StuartKenny/PRS10_rack/README.md

# PRS10
PSU and USB connectivity for PRS10 enclosure
