StuartKenny/PRS10_rack/Panel/PanelNotes.docx

# PRS10 Front Panel

# Software output format

dxf format required for laser cutter

Autodesk. From the dwg view – File > Save As > Save Copy As > DXF File. Need to make sure that letters are raised or lowered as an extrusion so that they register correctly.

Corel Draw is easy and recommended

# Dimensions

Panel - 88x399mm

LEDs - 5mm dia (on 15mm centres)

screws - 3mm dia

USB - 10.7mm tall x 12mm wide

switch - 20.2mm dia plus manual 2.2x0.9mm notch

RF connectors - 6.55mm dia flattened to 6.12

# Logo

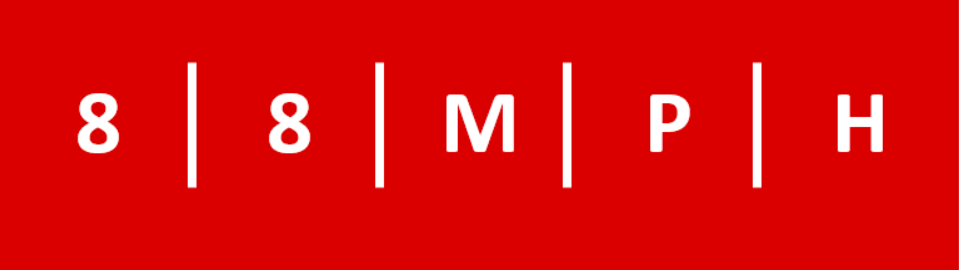
[picture p7: figure]
