StuartKenny/PRS10_rack/PRS10_BoM.xlsx

Sheet: PRS10
Designator | P/N | Description |  | Qty | Link
Xformer | MCTA080/12 | 2x12V 80VA toroid |  | 1 | http://uk.farnell.com/multicomp/mcta080-12/transformer-toroidal-2-x-12v-80va/dp/9532706
 | RIS0422H2 | Fused, filtered, switched mains inlet |  | 1 | http://uk.farnell.com/roxburgh/ris0422h2/filter-inlet-iec-4a-twin-fused/dp/1428692
 | 0213001.MXP | Fuse - 1A anti-surge |  | 1 | https://uk.rs-online.com/web/p/cartridge-fuses/5412931/
 | R13244AAAA | DPST switch |  | 1 | http://uk.farnell.com/arcolectric/r13244aaaa/switch-dpst-10a-250vac-black-i/dp/7674090
 | 0-0031894-0 | M6 crimp ring |  | 2 | http://uk.farnell.com/amp-te-connectivity/0-0031894-0/terminal-ring-tongue-6mm-crimp/dp/4217391?st=m6%20crimp
 | 34162 | M6 crimp ring |  |  | http://uk.farnell.com/amp-te-connectivity/34162/terminal-ring-tongue/dp/1557046
 | 165035 | M6 crimp ring |  |  | http://uk.farnell.com/amp-te-connectivity/165035/terminal-ring-tongue-1-4-10awg/dp/2506323
 | 2-520184-4 | Faston crimp terminals |  | 3 | http://uk.farnell.com/amp-te-connectivity/2-520184-4/terminal-female-disconnect-22/dp/2293338
 |  | Earth cable
 | 14825295 | Case |  | 1 | https://uk.rs-online.com/web/p/rack-fitting-cases-enclosures/8104359/
 | 345AB1000B | TO-66 Heatsink |  | 1 | http://uk.farnell.com/abl-heatsinks/345ab1000b/heat-sink-1-c-w/dp/150016
 | 520AB0750MB(T03) | TO-3 heatsink |  | 1 | http://uk.farnell.com/abl-heatsinks/520ab0750mb-t03/heat-sink-to-3-1-65-c-w/dp/253716
 | 534-4726 | TO-66-2 mounting kit | Mouser | 2 | https://www.mouser.co.uk/ProductDetail/Keystone-Electronics/4726
 | MK3301/51 | TO-3 insulator |  | 1 | http://uk.farnell.com/multicomp/mk3301-51/insulating-kit-mica-to-3/dp/520184?st=to-3%20mounting%20kit
 | MK3304 | Screws for TO-3 & TO-66 |  | 1 | https://uk.rs-online.com/web/p/heatsink-mounting-accessories/0298493/?searchTerm=to-66+mounting
 | R1811B91 | PCB stand-offs |  |  | https://uk.rs-online.com/web/p/hex-spacers/1057754/
 | 142-0701-401 | SMA sockets |  | 3 | https://uk.rs-online.com/web/p/sma-connectors/8861074/
 | PD.2115BL | Feet |  | 4 | http://uk.farnell.com/multicomp/pd-2115bl/feet-stick-on-5x11-1dia-blk-pk55/dp/1800839
 | 81.58.336 | PRS10 screws - #4-40 UNC-2B 0.25" deep | Fastpack | 4 | http://uk.farnell.com/ettinger/81-58-336/screw-pan-head-pozi-steel-m3-8mm/dp/2494539?st=m3%20screw
 | MRPM030040CB | Black M3 40mm screws |  | 7 | http://uk.farnell.com/unbranded/mrpm030040cb/screw-pan-head-pz-m3-x-40mm-pk50/dp/2528959?st=m3+screw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
 | M3- HFST-Z100- | M3 nuts |  | 7 | http://uk.farnell.com/duratool/m3-hfst-z100/nut-full-steel-bzp-m3-pk100/dp/1419447
 | DM3-FASTWAZ100DIN125 | M3 washers |  | 7 | http://uk.farnell.com/duratool/dm3-fastwaz100din125/plain-washer-steel-3mm-7mm/dp/2506007
 | N80.375 PRSTABB100- | No.8 self tapping screws |  | 8 | http://uk.farnell.com/tr-fastenings/n80-375-prstabb100/screw-pozi-pan-steel-blk-8x3-8/dp/1420523
J7 | 61400416121 | Right angle USB PCB connector |  | 1 | https://uk.rs-online.com/web/p/type-b-usb-connectors/7480866/
J2 | FME008P102 | 50 Ohm, co-axial R/A plug |  | 1 | https://www.mouser.co.uk/productdetail/fct-electronics/fme008p102
J2 | FM11W1S5-K121 | 11W1 socket, PCB 90degrees | Mouser | 1 | https://www.mouser.co.uk/ProductDetail/FCT-Electronics/173107-0319
J6 | M22-7131042 | 10 way receptacle |  | 1
J3 | M22-2031005 | 10 way right-angle header |  | 1
J5 | M22-7130842 | 8 way receptacle |  | 1
J4 | M22-2030805 | 8 way right-angle header |  | 1
J1, J8 | 790-1082 | 8-way terminal block |  | 2 | https://uk.rs-online.com/web/p/pcb-terminal-blocks/7901082/
 | 790-1076 | 4-way terminal block |  | 1 | https://uk.rs-online.com/web/p/pcb-terminal-blocks/7901076/
L1 | MMZ2012S601A | Ferrite, 600R @ 100MHz, 500mA, 0805 package |  | 1 | https://www.mouser.co.uk/ProductDetail/?qs=g8DL0B6GkTnXrzduh8Z92A%3D%3D
Q1 | 2N3054 | NPN power transistor | Mouser | 2 | https://www.mouser.co.uk/ProductDetail/Central-Semiconductor/2N3054/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
 | BSS64 | NPN transistor SOT23 |  | 1
 | FT231XS | RS232 to USB chip, SSOP-20 |  | 1 | https://www.sci-ware-customer.com/sword/catalogueItem.do?context=search&key=15069497
 | LM723CN | IC REG LIN POS ADJ 150MA 14DIP |  | 2 | https://www.sci-ware-customer.com/sword/catalogueItem.do?context=search&key=18970898
 | LM833 | Dual op-amp
 | 2N4401 | NPN BJT
 | LM338K | TO-3 voltage regulator |  | 1
 | 1N4002 | 1A 100V silicon rectifier |  | 2
BR1 | KBU4G | Bridge rectifier 400V 4A |  | 1 | https://uk.rs-online.com/web/p/products/6296667/
 | L7113SGD-LC27SF1.5 | 5mm green LED |  | 6 | https://uk.rs-online.com/web/p/visible-leds/6466658/
C1 | MC1206N101J500CT | 100pF 1206 capacitor |  | 4 | http://uk.farnell.com/multicomp/mc1206n101j500ct/cap-mlcc-c0g-np0-100pf-50v-1206/dp/1759327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
 | MC1206B103K500CT | 10nF 1206 capacitor |  | 1 | http://uk.farnell.com/multicomp/mc1206b103k500ct/cap-mlcc-x7r-10nf-50v-1206/dp/1759350
 | MC1206B104K500CT | 100nF 1206 capacitor |  | 5 | http://uk.farnell.com/multicomp/mc1206b104k500ct/cap-mlcc-x7r-100nf-50v-1206/dp/1759361
 | MC1206B105K500CT | 1uF capacitor |  | 1 | http://uk.farnell.com/multicomp/mc1206b105k500ct/cap-mlcc-x7r-1uf-50v-1206/dp/1759454
 | MC1206B475K500CT | 4.7uF capacitor |  | 3 | http://uk.farnell.com/multicomp/mc1206b475k500ct/cap-mlcc-x7r-4-7uf-50v-1206/dp/2320908
 | MCRH50V226M5X11 | 22uF |  | 2 | http://uk.farnell.com/multicomp/mcrh50v226m5x11/cap-alu-elec-22uf-50v-rad/dp/1902929
 | ECA-2AM101 | 100u cap |  | 1 | https://www.digikey.com/product-detail/en/panasonic-electronic-components/ECA-2AM101/P5313-ND/245067
 | MCKLZ100M472P40Y | 4700u, 100V electrolytic |  | 2 | http://uk.farnell.com/multicomp/mcklz100m472p40y/cap-alu-elec-4700uf-100v-snap/dp/2610775
 | 3269W-1-102LF | 1k trimmer, 250mW, 10% |  | 2 | http://uk.farnell.com/bourns/3269w-1-102lf/trimmer-smd-12-turn-1k/dp/9352953?st=3269W-1-102LF
RV2 | 3269W-1-501LF | 500R trimmer, 250mW, 10% |  | 1 | http://uk.farnell.com/bourns/3269w-1-501lf/trimmer-12-turn-500r-0-25w/dp/1612581?pf=110167406%2C112882636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
 | ERJ8CWFR050V | 0.05R 1W 1206 1% |  | 2 | http://uk.farnell.com/panasonic-electronic-components/erj8cwfr050v/resistor-thick-film-1206-0-05r/dp/2253991
 | CRG1206F15R | 15R |  | 2
 | CRCW120627R0FKEA | 27R 1206 resistor |  | 2
 | CRG1206F120R | 120R 1206 resistor |  | 1
 | CRG1206F220R | 220R |  | 2
 | CRG1206F270R | 270R 1206 resistor |  | 2 | https://uk.rs-online.com/web/p/surface-mount-fixed-resistors/2232136/
 | CRG1206F470R | 470R |  | 2
 | CRG1206F1K0 | 1k 1206 resistor |  | 3
 | CRG1206F1K2 | 1.2k 1206 resistor |  | 3
 | CRG1206F1K5 | 1.5k 1206 resistor |  | 2
 | CRG1206F2K0 | 2k 1206 resistor |  | 1 | https://uk.rs-online.com/web/p/surface-mount-fixed-resistors/2232300/
 | WCR1206-4K3FI | 4k3 |  | 2
R2 | CRG1206F6K8 | 6.8k 1206 resistor |  | 2
 | CRG1206F8K2 | 8.2k 1206 resistor |  | 1
R3 | ERA8AEB912V | 9.1k 1206 resistor |  | 2
 | CRG1206F10K | 10k 1206 resistor |  | 3
 | CRG1206F22K | 22k 1206 resistor |  | 2 | RHM22.0KAITR-ND (https://www.digikey.co.uk/product-detail/en/rohm-semiconductor/KTR18EZPF2202/RHM22.0KAITR-ND/1983713)
 | CRG1206F47k | 47k |  | 2
 | WCR1206-300KFI | 300k |  | 2

Sheet: Awaiting
Order | Supplier | P/N | Description
419001 | RS | 1251190P | CRG1206 SMT Chip Resistor 1K 0.25W
419002 | Onecall | 2320908 | CAP, MLCC, X7R, 4.7UF, 50V, 1206
419116 | Onecall |  | 100uF caps
 |  | ERJ8ENF2001V | 2k resistors?

Sheet: Misc_kit
Designator | P/N | Description | Qty | Link
 | 430019 | Crimp tool | 1 | http://uk.farnell.com/ck-tools/430019/ratchet-crimping-pliers/dp/1879381?MER=sy-me-pd-mi-alte
 | D00391 | Torq bits |  | http://uk.farnell.com/duratool/d00391/bit-set-security-33pc/dp/1341140?st=torq
 | 5011-A3C | Ratchet screwdriver | 1 | http://uk.farnell.com/duratool/5011-a3c/screwdriver-ratchet-6-bits/dp/3126821?st=ratchet%20screwdriver
 | 553-0500-01 | Red 4mm plugs | 5 | http://uk.farnell.com/deltron-components/553-0500-01/plug-4mm-stackable-red-16a/dp/1101099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
 | 553-0100-01 | Black 4mm plugs | 5 | http://uk.farnell.com/deltron-components/553-0100-01/plug-4mm-stackable-black-16a/dp/1101106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
 | 553-0200-01 | Blue 4mm plugs | 5 | http://uk.farnell.com/deltron-components/553-0200-01/plug-10a-4mm-stackable-cable-blue/dp/1101108
 | 553-0400-01 | Green 4mm plugs | 5 | http://uk.farnell.com/deltron-components/553-0400-01/plug-10a-4mm-stackable-cable-green/dp/1101107
 | 553-0700-01 | Yellow 4mm plugs | 5 | http://uk.farnell.com/deltron-components/553-0700-01/banana-plug-10a-4mm-stackable/dp/1101111
 | HS510-1.22M | Heatshrink 1.5mm |  | http://uk.farnell.com/pro-power/sp3x15-1-2-black/heatshrink-1-5mm-black-1-2m/dp/1191009
 | HS511-1.22M | Heatshrink 3mm |  | http://uk.farnell.com/pro-power/hs511-1-22m/heatshrink-3mm-black-1-22m/dp/1259195
 | HS512-1.22M | Heatshrink 4.5mm |  | http://uk.farnell.com/pro-power/hs512-1-22m/heatshrink-4-5mm-black-1-2m/dp/1259196
 | HS513-1.22M | Heatshrink 6mm |  | http://uk.farnell.com/pro-power/sp3x6-2-1-2mblack/heatshrink-6mm-black-1-2m/dp/1191012
 | HS514-1.22M | Heatshrink 9mm |  | http://uk.farnell.com/pro-power/hs514-1-22m/heatshrink-3-1-9mm-black-1-22m/dp/1259198

Sheet: Considered
Designator | P/N | Description | Link
PSU | LS75-24 | 24V 3.2A PSU | http://uk.farnell.com/tdk-lambda/ls75-24/psu-enclosed-24v-3-2a-75w/dp/1657447?mckv=YO18ZYDl_dc|pcrid|78108376509|&gross_price=true&CATCI=aud-157604796549:pla-41477300408&CAAGID=14406255429&CMP=KNC-GUK-GEN-SHOPPING&CAGPSPN=pla&gclid=CjwKCAiAtdDTBRArEiwAPT4y-4A-DQu4D2N3cmYq1lzJCUIhXC5sN3gK5JRb-vx67Er8iVF--yA4AxoCEMAQAvD_BwE&CAWELAID=120173390000288793
 | 28L0138-10R-10 | Ferrite, Axial Leaded, 75 ohm, 5 A, 0.01 ohm | http://uk.farnell.com/laird-technologies/28l0138-10r-10/filter-3-5x4-5-59mm-100mhz-75r/dp/2292304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
 | PM5.08/2/90 BLK | 2-way terminal block | http://uk.farnell.com/weidmuller/pm5-08-2-90-blk/terminal-block-wire-to-brd-2pos/dp/1131855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
 | RIR-0422-H | Fused, filtered mains inlet | http://uk.farnell.com/roxburgh/rir-0422-h/filter-4a-fused/dp/1101083
 | AU-Y1007-R | Right angle USB PCB connector | Obsolete
 | FME008P102 | 50 Ohm, co-axial R/A plug | Not stocked | http://uk.farnell.com/fct-a-molex-company/fme008p102/koaxial-connector/dp/2433193
R1 | 9C12063A2202FKHFT | 22k 1206 resistor |  | https://www.digikey.co.uk/product-detail/en/yageo/9C12063A2202FKHFT/311-22.0KFTR-ND/346657
 | MC1206N470J500CT | 47pF 1206 capacitor |  |  | http://uk.farnell.com/multicomp/mc1206n470j500ct/cap-mlcc-c0g-np0-47pf-50v-1206/dp/2320898
C1 | ecu-v1h101jch | 100pF 1206 capacitor |  | 4 | http://uk.farnell.com/multicomp/mc1206n101j500ct/cap-mlcc-c0g-np0-100pf-50v-1206/dp/1759327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
J6 | 25631001RP2 | 10 way receptacle | x | 1 | https://www.mouser.co.uk/productdetail/norcomp/25631001rp2
J3 | 27631002RP2 | 10 way right-angle header | x | 1 | https://www.mouser.co.uk/ProductDetail/NorComp/27631002RP2
J5 | 25630801RP2 | 8 way receptacle | x | 1
J4 | 27630802RP2 | 8 way right-angle header | x | 1
J7 | AU-Y1007 | Right angle USB PCB connector | Digikey | 1 | https://www.digikey.co.uk/product-detail/en/assmann-wsw-components/AU-Y1007/AE11183-ND/278928
 | ECF440 | PRS10 screws - M3x7mm (#4-40 UNC-2B 0.25" deep) | US stock |  | http://uk.farnell.com/l-com/ecf440/thread-size-metric/dp/2500400
 |  | Earth sleeve
 |  | Blue equipment wire | http://uk.farnell.com/pro-power/mc6a-1-0-6t2-be-100/equipment-wire-1-0-6mm-blue-100m/dp/1219343
RV1 | 3269P-1-102LF | 1k trimmer, 250mW, 10% |  | 1
 | PP000227 | Earth cable |  | 1 | http://uk.farnell.com/pro-power/pp000227/hook-up-wire-20awg-grn-yel-per/dp/2707912
 | 790-1070 | 5-way terminal block |  | 1 | https://uk.rs-online.com/web/p/pcb-terminal-blocks/7901070/

Sheet: RS232
Designator | P/N | Description | Qty | Link
 | CRG1206F10K | 10k 1206 resistor | 3
 | 74LS04 | Hex inverter DIP package | 1 | https://www.sci-ware-customer.com/sword/catalogueItem.do?context=search&key=43722539
 | L77SDE09SA4CH4R | 9-pin Dsub receptacle | 1 | http://uk.farnell.com/amphenol-commercial-products/l77sde09sa4ch4r/d-sub-conn-r-a-rcpt-9pos-solder/dp/2709065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

Sheet: PRSBB
Designator | P/N | Description |  | Qty | Link
 | SMA-CONNECTOR | PCB mounting SMA connector |  | 3 | https://uk.rs-online.com/web/p/sma-connectors/7839638/
L1 | MMZ2012S601A | Ferrite, 600R @ 100MHz, 500mA, 0805 package |  | 1 | https://www.mouser.co.uk/ProductDetail/?qs=g8DL0B6GkTnXrzduh8Z92A%3D%3D
 | BSS64 | NPN transistor SOT23 |  | 1
 | FT231XS | RS232 to USB chip, SSOP-20 |  | 1 | https://www.sci-ware-customer.com/sword/catalogueItem.do?context=search&key=15069497
 | L7113SGD-LC27SF1.5 | 5mm green LED |  | 4 | https://uk.rs-online.com/web/p/visible-leds/6466658/
J7 | 61400416121 | Right angle USB PCB connector |  | 1 | https://uk.rs-online.com/web/p/type-b-usb-connectors/7480866/
J2 | FME008P102 | 50 Ohm, co-axial R/A plug | RS | 1 | https://www.mouser.co.uk/productdetail/fct-electronics/fme008p102
J2 | FM11W1S5-K121 | 11W1 socket, PCB 90degrees | Mouser | 1 | https://www.mouser.co.uk/ProductDetail/FCT-Electronics/173107-0319
C1 | MC1206N101J500CT | 100pF 1206 capacitor |  | 2 | http://uk.farnell.com/multicomp/mc1206n101j500ct/cap-mlcc-c0g-np0-100pf-50v-1206/dp/1759327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
 | MC1206B103K500CT | 10nF 1206 capacitor |  | 1 | http://uk.farnell.com/multicomp/mc1206b103k500ct/cap-mlcc-x7r-10nf-50v-1206/dp/1759350
 | MC1206B104K500CT | 100nF 1206 capacitor |  | 4 | http://uk.farnell.com/multicomp/mc1206b104k500ct/cap-mlcc-x7r-100nf-50v-1206/dp/1759361
 | UMK316BJ475KL-T | 4.7uF capacitor |  | 1 | http://uk.farnell.com/multicomp/mc1206b475k500ct/cap-mlcc-x7r-4-7uf-50v-1206/dp/2320908
 | CRCW120627R0FKEA | 27R 1206 resistor |  | 2
 | CRG1206F270R | 270R 1206 resistor |  | 2 | https://uk.rs-online.com/web/p/surface-mount-fixed-resistors/2232136/
 | MCWR12X1001FTL | 1k 1206 resistor |  | 2
 | CRG1206F1K2 | 1.2k 1206 resistor |  | 2
 | CRG1206F8K2 | 8.2k 1206 resistor |  | 1
 | CRG1206F10K | 10k 1206 resistor |  | 3
