StuartKenny/PRS10_rack/Datasheets/RM2U0808VBK.stp

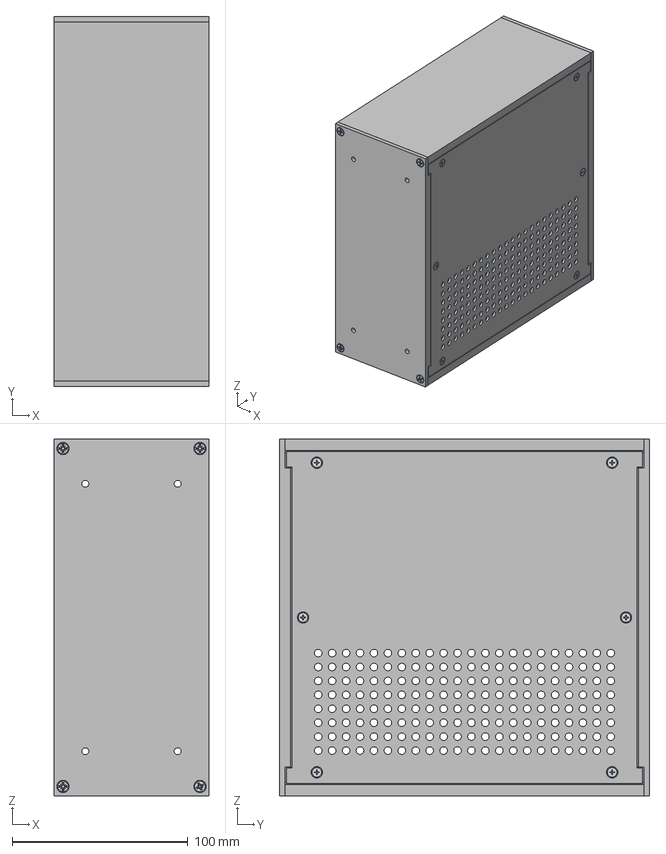
[picture p8: CAD file, 2018-02-23]
Datasheets/RM2U0808VBK.stp
88.1 x 210.8 x 203.2 mm
2U Side 8in x 2
2U Front x 2
AS B194 CR1 B No. 4 x 3/8-CR1 B x 13
Cross Recessed Flat Countersunk Head Tapping Screw - Type C - Type IA - Inch 6-32 UNC - 0.625 x 8
tinnerman Nut - 4-40 x 12
Vented Top Panel x 2
