StuartKenny/PRS10_rack/Panel/Panelv03.dxf

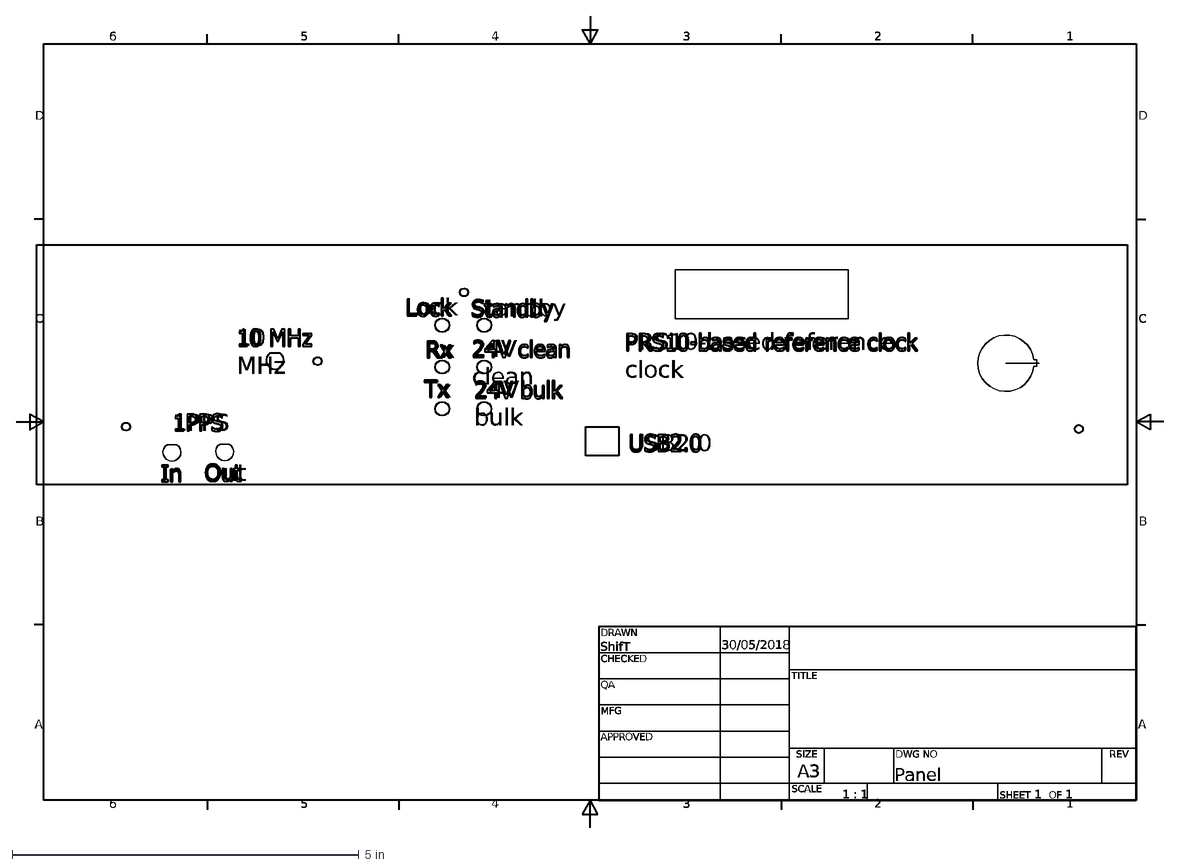
[picture p9: CAD file, 2018-06-04]
Panel/Panelv03.dxf
1
2
3
4
5
6
A
B
C
D
ShifT
30/05/2018
Panel
A3
1 : 1
SHEET 1 OF 1
DRAWN
CHECKED
QA
MFG
APPROVED
DWG NO
TITLE
SIZE
SCALE
REV
Rx
Tx
24V bulk
24V clean
Standby
USB2.0
1PPS
Out
Lock
10 MHz
PRS10-based reference clock
In
