StuartKenny/PRS10_rack/(list of files, cad)

Other CAD files:
Panel/Panel.dwg
Panel/try1.dwg
Panel/OldVersions/Panel.0004.dwg
3D/Enclosure.ipt
3D/OldVersions/Enclosure.0001.ipt
Panel/OldVersions/Panel.0014.ipt
Panel/Panel.ipt
