StuartKenny/PRS10_rack/Mobo_schematics_v0.4.pdf

# AC to DC conversion

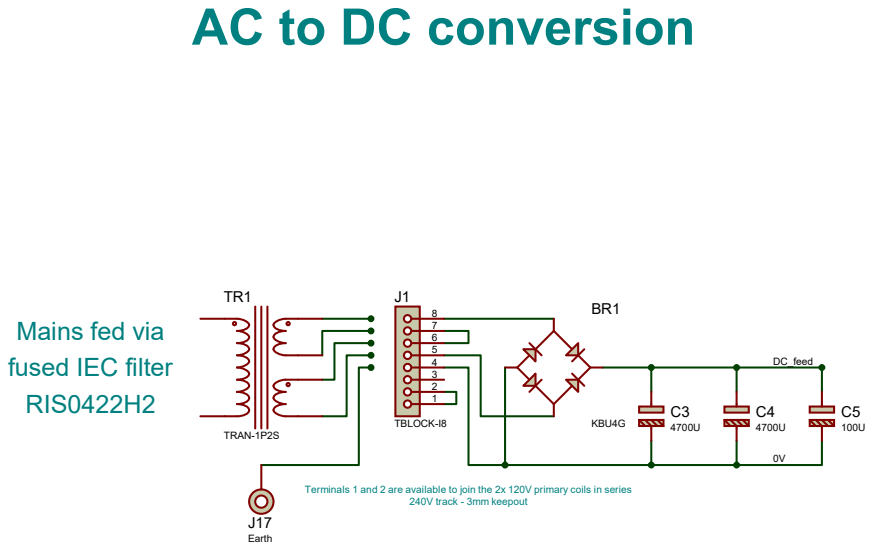
[picture p10: page 1]
DC_feed; TRAN-1P2S; KBU4G; TBLOCK-I8; Earth; 240V track - 3mm keepout

Mains fed via
fused IEC filter
RIS0422H2

Terminals 1 and 2 are available to join the 2x 120V primary coils in series

R3

# Voltage regulators

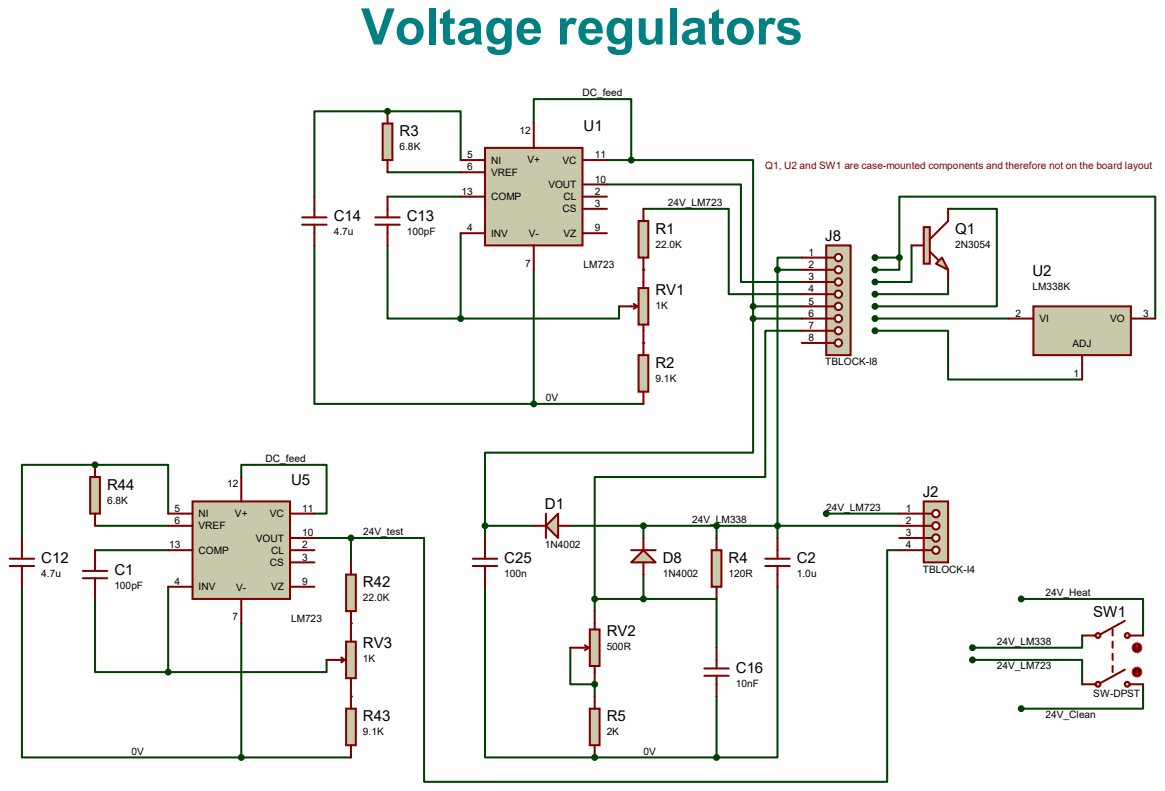
[picture p11: page 2]

Q1, U2 and SW1 are case-mounted components and therefore not on the board layout

# Wenzel shunts

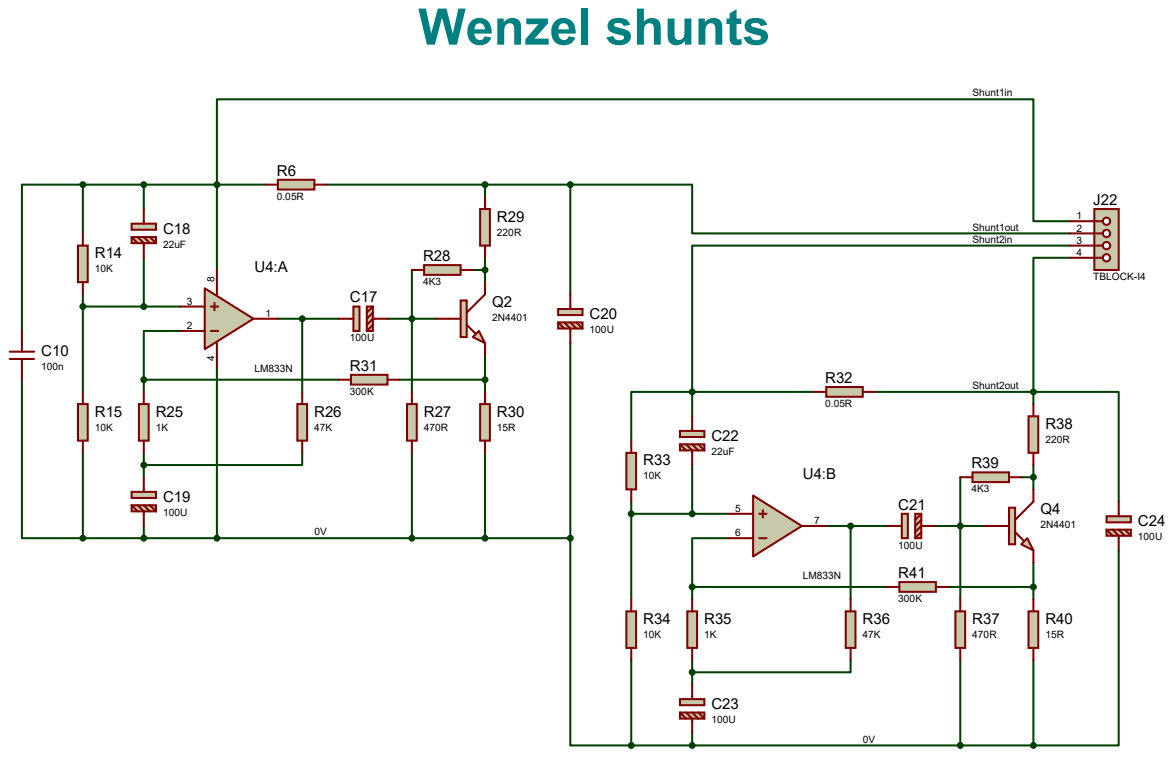
[picture p12: page 3]

# RS232 to USB conversion

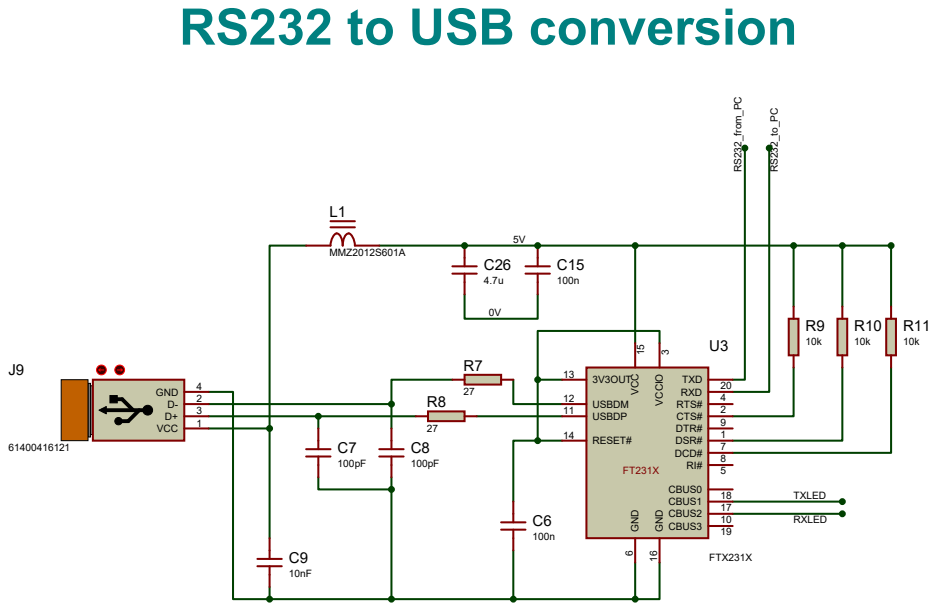
[picture p13: page 4]

# Daughterboard connectors

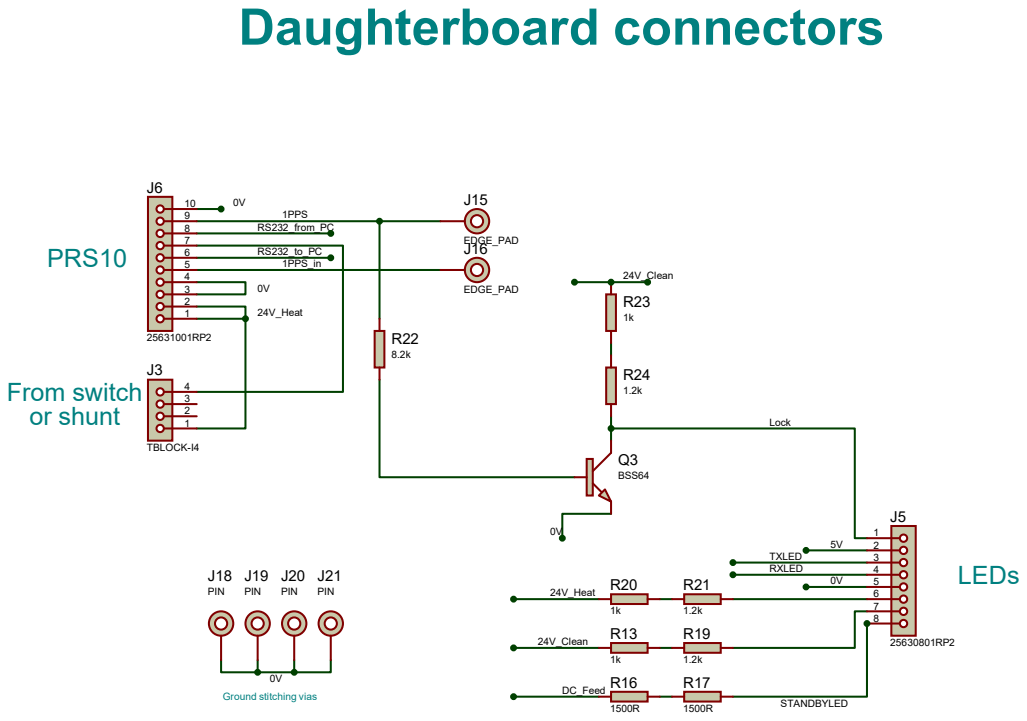
[picture p14: page 5]
