StuartKenny/PRS10_rack/Schematics_v0.3.pdf

# AC to DC conversion

DC_feed; TRAN-1P2S; KBU4G; TBLOCK-I8; Earth; 240V track - 3mm keepout

Mains fed via
fused IEC filter
RIS0422H2

Terminals 1 and 2 are available to join the 2x 120V primary coils in series

R3

# Voltage regulators

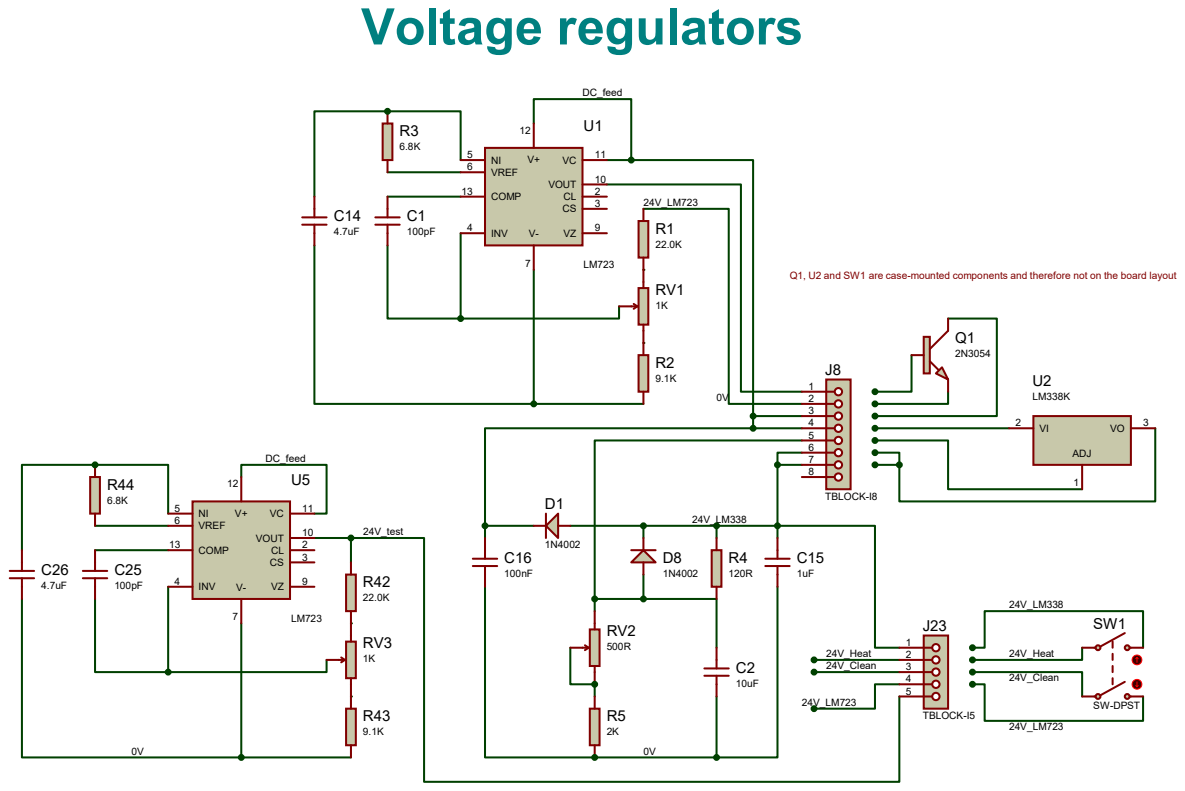
[picture p15: page 2]

Q1, U2 and SW1 are case-mounted components and therefore not on the board layout

# Wenzel shunts

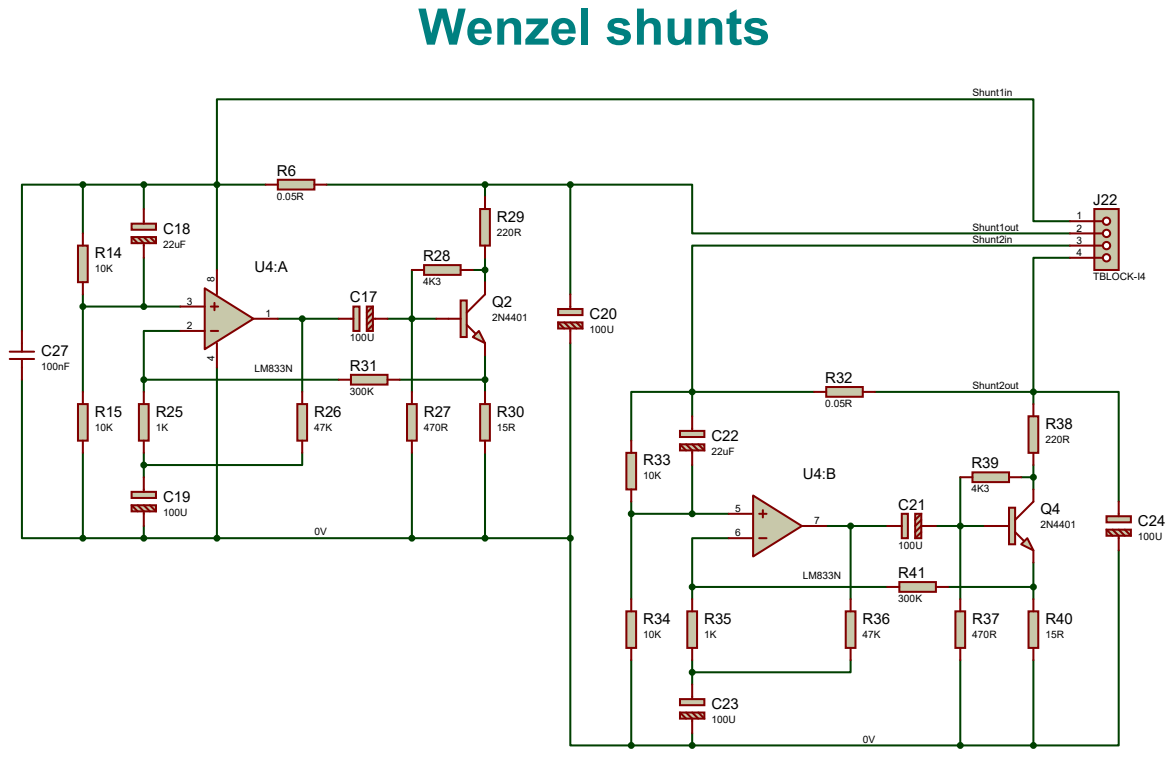
[picture p16: page 3]

# RS232 to USB conversion

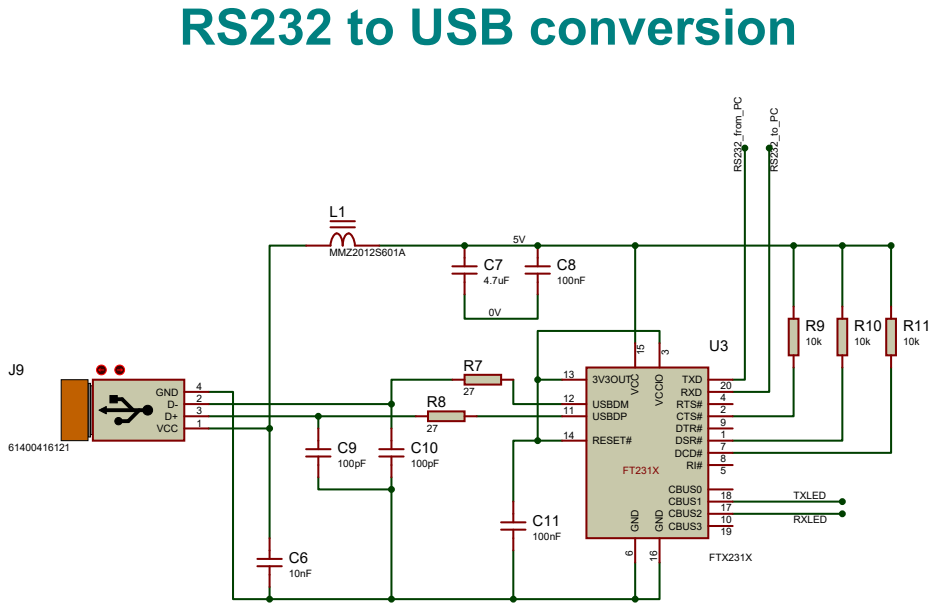
[picture p17: page 4]

# Daughterboard connectors

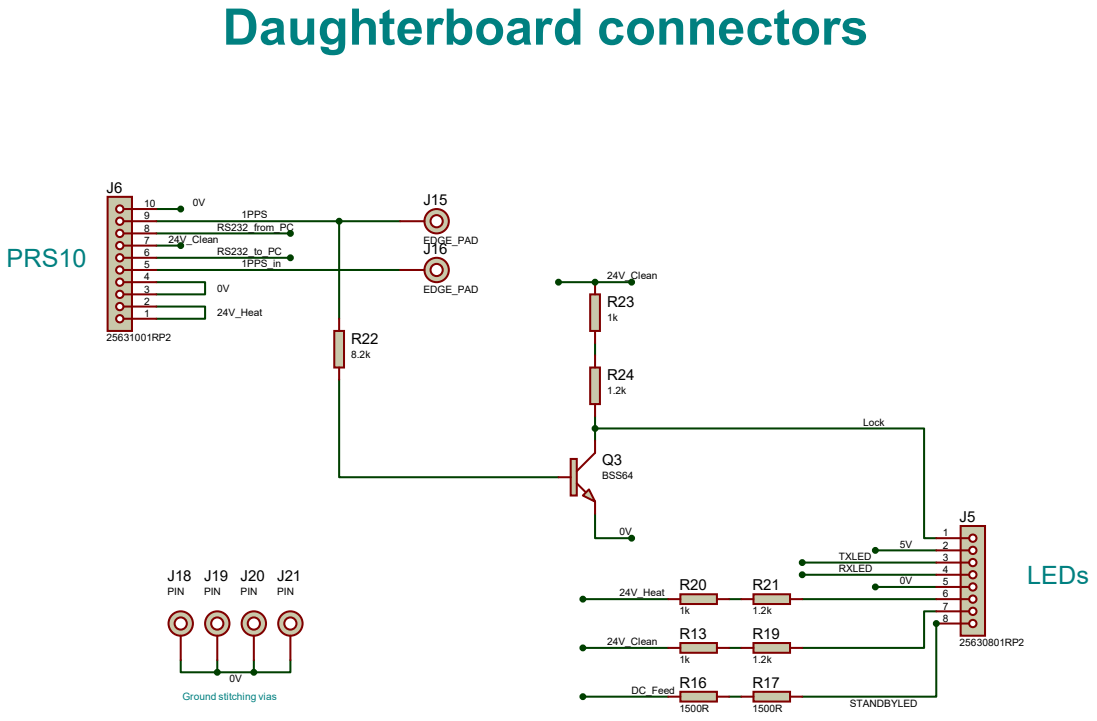
[picture p18: page 5]

# PRS10 connector daughterboard

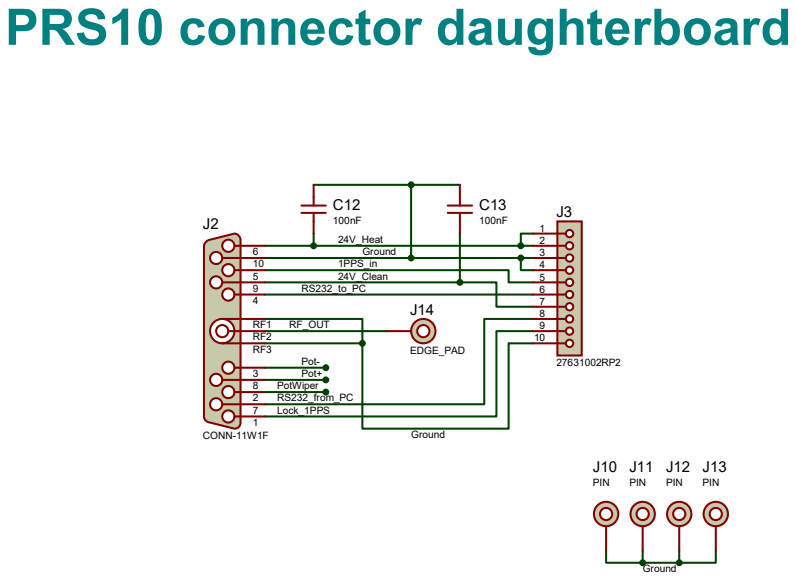
[picture p19: page 6]

D6
D7

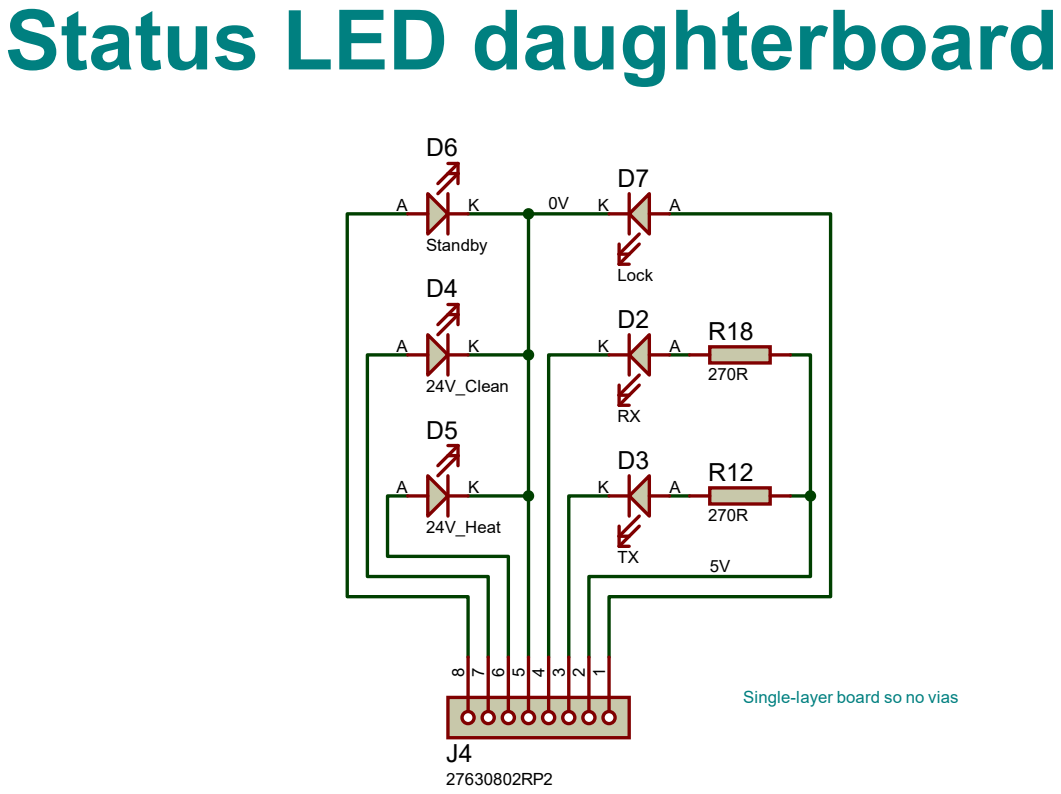
[picture p20: page 7]
Standby; 24V_Clean; 24V_Heat; Lock

Status LED daughterboard

Single-layer board so no vias
