StuartKenny/PRS10_rack/Schematics_v0.1.pdf

# AC to DC conversion

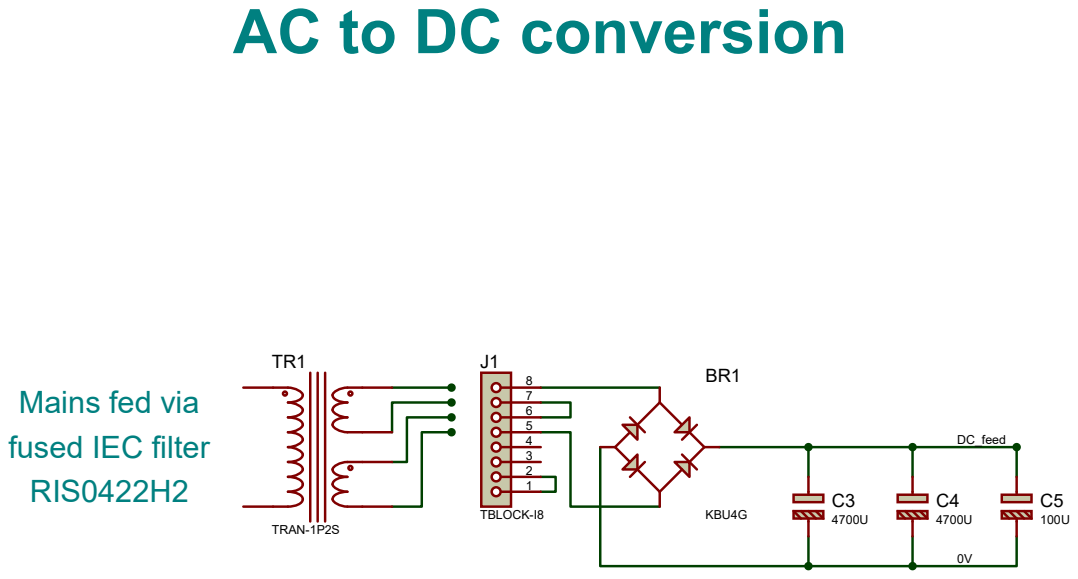
[picture p21: page 1]
DC_feed; TRAN-1P2S; KBU4G; TBLOCK-I8

Mains fed via
fused IEC filter
RIS0422H2

R3

# Voltage regulators

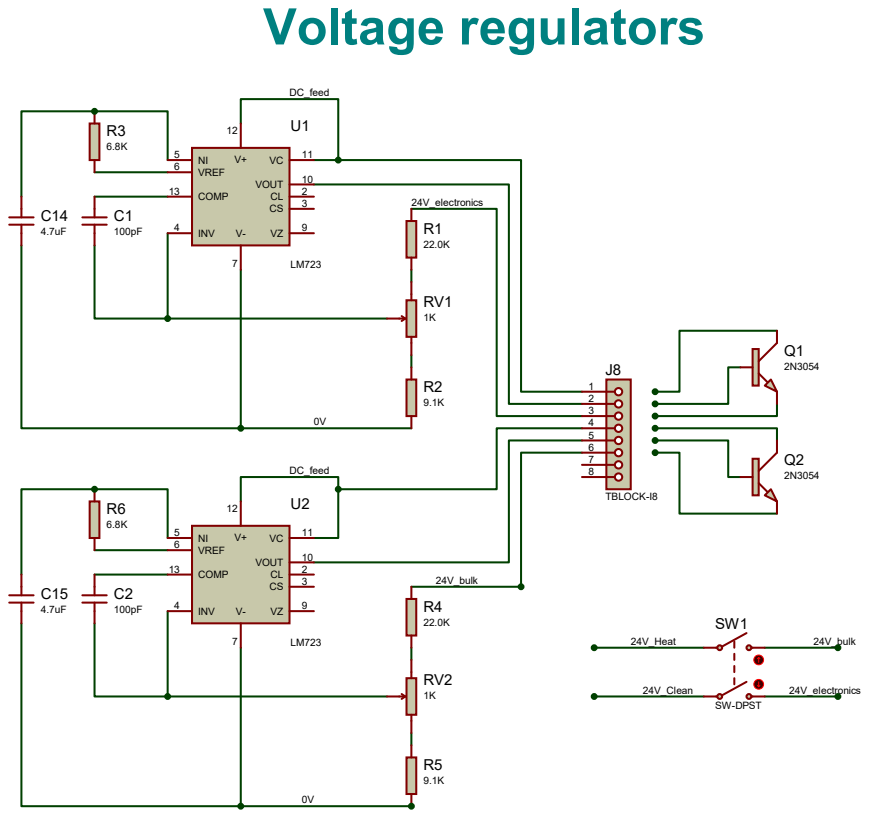
[picture p22: page 2]

# RS232 to USB conversion

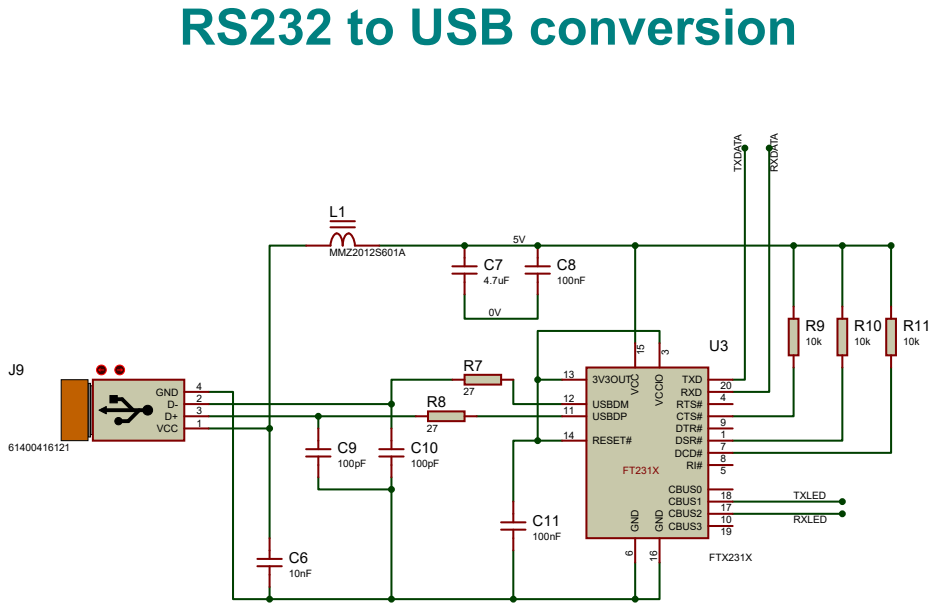
[picture p23: page 3]

# PRS10 connector daughterboard

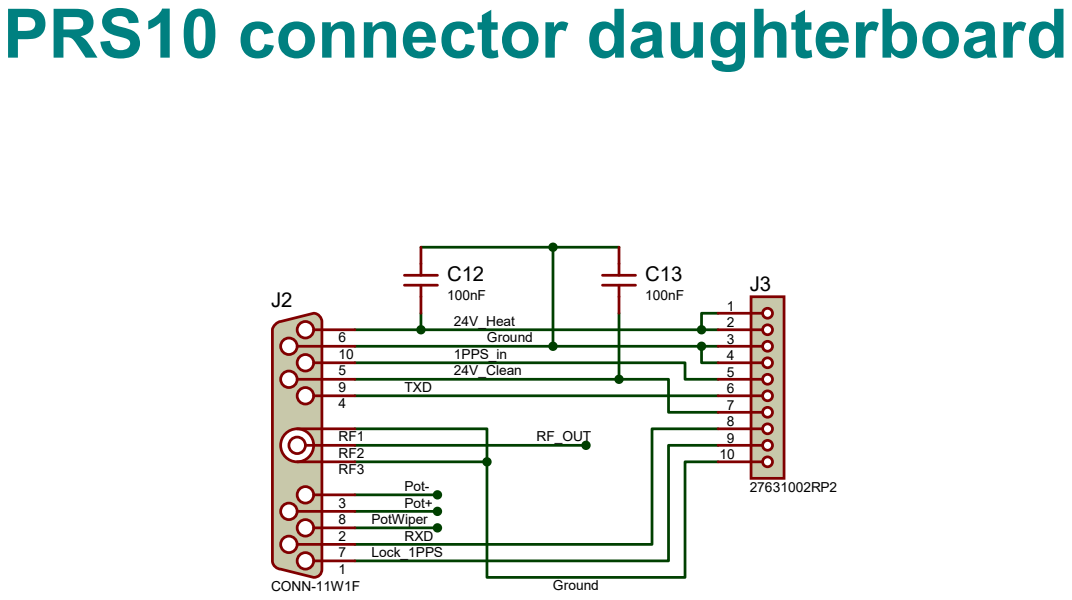
[picture p24: page 4]
PotWiper; Pot+; Pot-; 1PPS_in; TXD; RXD Lock_1PPS; RF_OUT; Ground; 24V_Heat Ground; 24V_Clean; CONN-11W1F

D6
D7

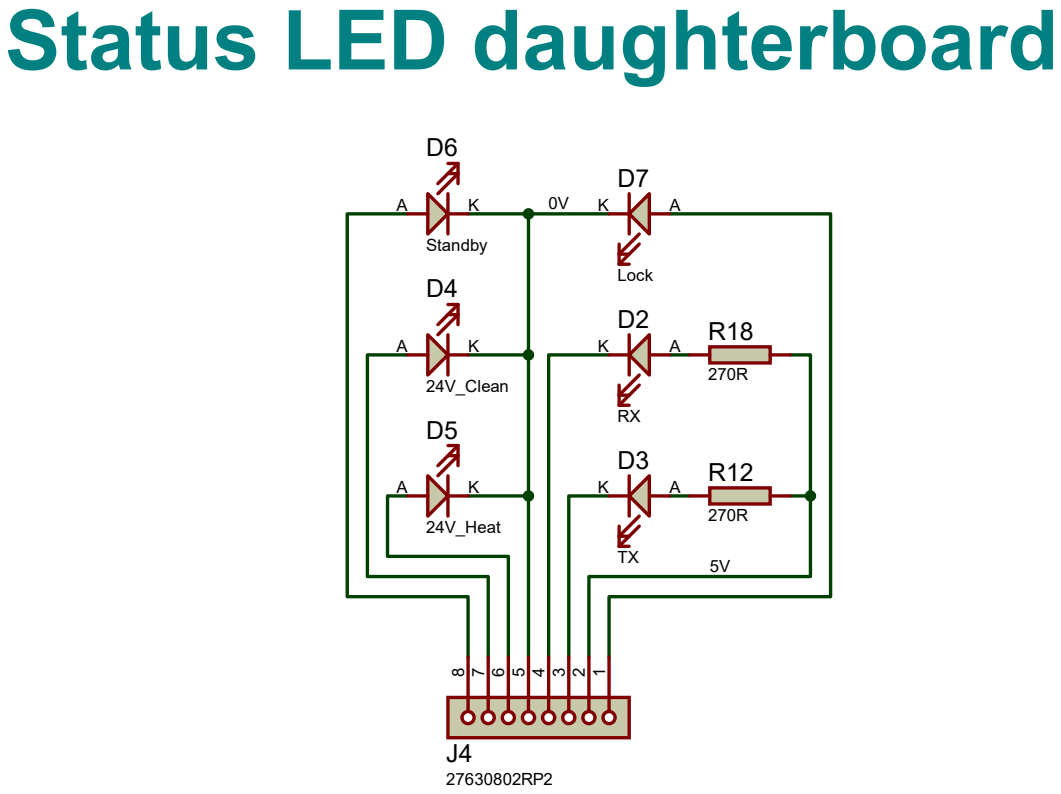
[picture p25: page 5]
Standby; 24V_Clean; 24V_Heat; Lock

Status LED daughterboard

# Daughterboard connectors

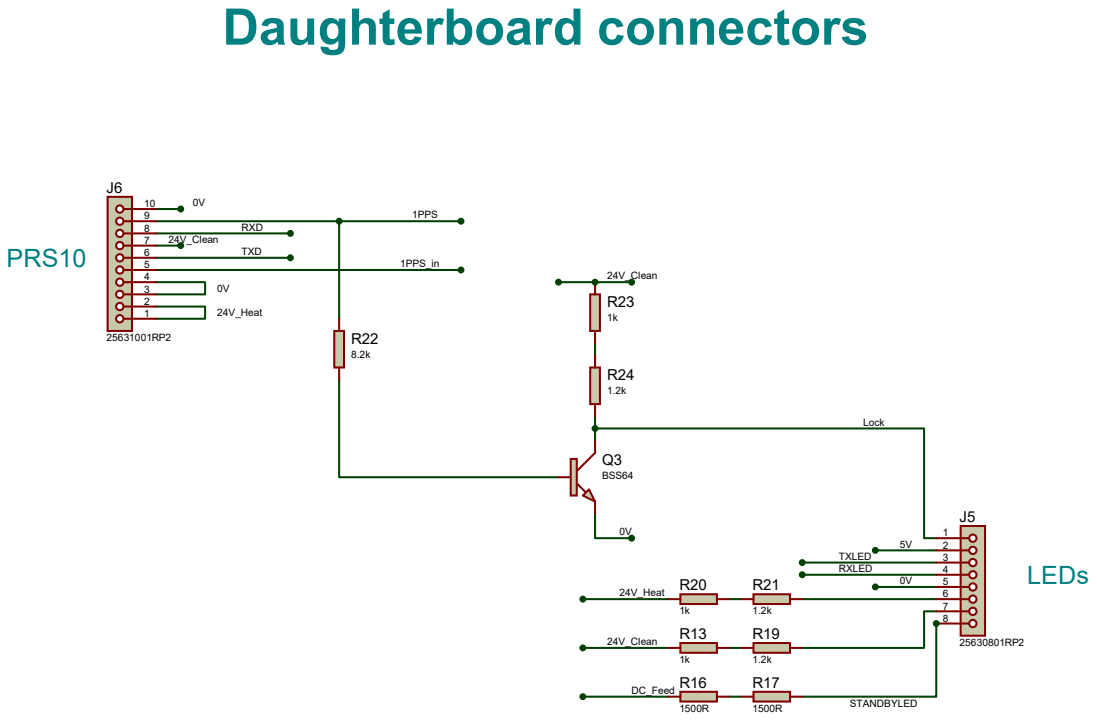
[picture p26: page 6]
