StuartKenny/PRS10_rack/(list of files, drawings)

Other design files:
Definitions/Component_defn.pdsprj
LED/LED_daughterboard.pdsprj
Mobo/PRS10.pdsprj
PRS10Connector/PRS10_connectorboard.pdsprj
PRSBB2/PRSBB2.pdsprj
RS232/RS232.pdsprj
