StuartKenny/PRS10_rack/Panel/PANELV3.INI

[Technics_Laser_Data]
ModifyTechCFG=0
LayersNumber=5
LayerColor_0=0
LayerColor_1=16711680
ExportRows=1
ExportColumns=1
ExportRowSpace=0.00000
ExportColumnSpace=0.00000
ExportRowCW=0.00000
ExportColumnCW=0.00000
LogicOrgPositionX=852.25399
LogicOrgPositionY=356.33769
LogicOrgPositionZ=-9999999.00000
AtOnceExport=1
IsTwoLaserWorking=0
TableZeroPositionX=0.00000
TableZeroPositionY=0.00000
OutputTimes=1
DelayTime=0
FeedLength=0.00000
FeedSpeed=5.00000
FeedDelayTime=0
MinX=453.25399
MaxX=852.25399
MinY=268.33769
MaxY=356.33769
ChangeSerialNo=0
ArrayMinX=453.25399
ArrayMaxX=852.25399
ArrayMinY=268.33769
ArrayMaxY=356.33769
ClipBoxPower=40.00000
ClipBoxPower2=40.00000
ClipBoxOffsetLen=2.00000
ClipBoxSpeed=25.00000
AlignMachineZPos=0.00000
RouteLength=0.00000
RoutePointNumber=0
OffsetLaserPower=0.00000
OffsetWorkSpeedPer=1.00000
ZHeightForLaserFocus=0.00000
LayerColor_2=12615935
LayerColor_3=65280
LayerColor_4=255
OneWorkNeedTimes=2
TotalWorkTimes=0
[CoordSystem_0]
LogicOrgPosition1=852.25399
LogicOrgPosition2=356.33769
LogicOrgPosition3=-9999999.00000
SPLITBLOCK_NUMBER=2
SPLITBLOCK_NUMBER_0=0.00000
SPLITBLOCK_NUMBER_1=100000.00000
[CreateTechnicsCodeMgr]
PrjHasModifyCFG=1
[TechnicsLayers_0]
TechnicsMode=TECHNICS_LASERENGRAVE
LaserEngravePower=25.00000
LaserEngravePower2=60.00000
LaserEngraveFrequency=20000
LaserEngraveSpeed=400.00000
LaserEngraveBlowGasType=1
LaserEngraveFillCircleR=2.50000
LaserEngraveFillCircleSpace=2.50000
LaserEngraveFillCircle=0
LaserEngraveFillCircleType=0
LaserEngraveTwoDirector=0
LaserEngraveScanDirector=1
LaserEngraveScanStepLen=0.06400
LaserEngraveExpandPenWidth=0
LaserEngraveExpandPenWidthScale=15.00000
GROUP_ROWS_0=1
GROUP_COLUMNS_0=1
GROUP_ROWSPACE_0=0.00000
GROUP_COLUMNSPACE_0=0.00000
GROUP_ROWCWSPACE_0=0.00000
GROUP_COLUMNCWSPACE_0=0.00000
GROUP_MINX_0=498.97291
GROUP_MAXX_0=553.88814
GROUP_MINY_0=269.53916
GROUP_MAXY_0=325.39152
[TechnicsLayers_255]
TechnicsMode=TECHNICS_LASERCUT
LaserEngravePower=40.00000
LaserEngravePower2=60.00000
LaserEngraveFrequency=20000
LaserEngraveSpeed=400.00000
LaserEngraveBlowGasType=1
LaserEngraveFillCircleR=2.50000
LaserEngraveFillCircleSpace=2.50000
LaserEngraveFillCircle=0
LaserEngraveFillCircleType=0
LaserEngraveTwoDirector=1
LaserEngraveScanDirector=1
LaserEngraveScanStepLen=0.09000
LaserEngraveExpandPenWidth=0
LaserEngraveExpandPenWidthScale=15.00000
LaserCutConnerPower=12.00000
LaserCutWorkPower=98.00000
LaserCutConnerPower2=30.00000
LaserCutWorkPower2=50.00000
LaserCutFrequency=20000
LaserCutOptimizePathType=1
LaserCutInnerToOuter=1
LaserCutInnerToOuter2=0
LaserCutDownToUpper=0
LaserCutBlockHeight=150.00000
LaserCutAutoSetPathDir=0
LaserCutCicleMinSegNumber=36
LaserCutDisperseLength=0.10000
LaserCutCloseGapLength=0.20000
LaserCutOverlapLength=0.00000
LaserCutAdjustForClose=0
LaserCutQXEnterLength=0.00000
LaserCutDelayMoveTime=0.00000
LaserCutOpenGZDelayTime=0.00000
LaserCutOpenLaserDelayTime=0.00000
LaserCutCloseLaserDelayTime=0.00000
LaserCutDelayTimeAfterCloseLaser=0.00000
LaserCutOneAxisBackLashLength=0.00000
LaserCutTwoAxisBackLashLength=0.00000
LaserCutBackLashAddSpaceLength=8.00000
LaserCutBlowGasType=2
LaserCutAheadBlowGasTimes=0.00000
LaserCutNoCloseGasTimes=0.00000
LaserCutSpeed=30.00000
LaserCutGWAcc=120.00000
LaserCutGWTime=0.01000
LaserCutTrackSize=100
LaserCutLineLength=0.00000
SpaceCutLineLength=0.00000
bSpaceLineFirst=0
LaserCutAdjustMove=0
LaserCutAdjustMoveDelay=0.00000
LaserCutUpLen=0.00000
LaserCutCircleSpeedNum=6
LaserCutCircleSpeed0_MinR=0.00000
LaserCutCircleSpeed0_MaxR=0.55000
LaserCutCircleSpeed0_Speed=10.00000
LaserCutCircleSpeed1_MinR=0.55000
LaserCutCircleSpeed1_MaxR=1.05000
LaserCutCircleSpeed1_Speed=15.00000
LaserCutCircleSpeed2_MinR=1.05000
LaserCutCircleSpeed2_MaxR=1.55000
LaserCutCircleSpeed2_Speed=25.00000
LaserCutCircleSpeed3_MinR=1.55000
LaserCutCircleSpeed3_MaxR=2.05000
LaserCutCircleSpeed3_Speed=30.00000
LaserCutCircleSpeed4_MinR=2.05000
LaserCutCircleSpeed4_MaxR=3.05000
LaserCutCircleSpeed4_Speed=35.00000
LaserCutCircleSpeed5_MinR=3.05000
LaserCutCircleSpeed5_MaxR=4.05000
LaserCutCircleSpeed5_Speed=40.00000
GROUP_ROWS_0=1
GROUP_COLUMNS_0=1
GROUP_ROWSPACE_0=0.00000
GROUP_COLUMNSPACE_0=0.00000
GROUP_ROWCWSPACE_0=0.00000
GROUP_COLUMNCWSPACE_0=0.00000
GROUP_MINX_0=453.25399
GROUP_MAXX_0=852.25399
GROUP_MINY_0=268.33769
GROUP_MAXY_0=356.33769
[TechnicsLayers_16711680]
TechnicsMode=TECHNICS_LASERENGRAVE
LaserEngravePower=25.00000
LaserEngravePower2=60.00000
LaserEngraveFrequency=20000
LaserEngraveSpeed=400.00000
LaserEngraveBlowGasType=1
LaserEngraveFillCircleR=2.50000
LaserEngraveFillCircleSpace=2.50000
LaserEngraveFillCircle=0
LaserEngraveFillCircleType=0
LaserEngraveTwoDirector=0
LaserEngraveScanDirector=1
LaserEngraveScanStepLen=0.06400
LaserEngraveExpandPenWidth=0
LaserEngraveExpandPenWidthScale=15.00000
GROUP_ROWS_0=1
GROUP_COLUMNS_0=1
GROUP_ROWSPACE_0=0.00000
GROUP_COLUMNSPACE_0=0.00000
GROUP_ROWCWSPACE_0=0.00000
GROUP_COLUMNCWSPACE_0=0.00000
GROUP_MINX_0=669.08155
GROUP_MAXX_0=775.72774
GROUP_MINY_0=317.39473
GROUP_MAXY_0=345.91508
[TechnicsLayers_65280]
TechnicsMode=TECHNICS_LASERENGRAVE
LaserEngravePower=25.00000
LaserEngravePower2=60.00000
LaserEngraveFrequency=20000
LaserEngraveSpeed=400.00000
LaserEngraveBlowGasType=1
LaserEngraveFillCircleR=2.50000
LaserEngraveFillCircleSpace=2.50000
LaserEngraveFillCircle=0
LaserEngraveFillCircleType=0
LaserEngraveTwoDirector=0
LaserEngraveScanDirector=1
LaserEngraveScanStepLen=0.06400
LaserEngraveExpandPenWidth=0
LaserEngraveExpandPenWidthScale=15.00000
GROUP_ROWS_0=1
GROUP_COLUMNS_0=1
GROUP_ROWSPACE_0=0.00000
GROUP_COLUMNSPACE_0=0.00000
GROUP_ROWCWSPACE_0=0.00000
GROUP_COLUMNCWSPACE_0=0.00000
GROUP_MINX_0=670.37469
GROUP_MAXX_0=696.30711
GROUP_MINY_0=280.48339
GROUP_MAXY_0=286.84044
[TechnicsLayers_12615935]
TechnicsMode=TECHNICS_LASERENGRAVE
LaserEngravePower=25.00000
LaserEngravePower2=60.00000
LaserEngraveFrequency=20000
LaserEngraveSpeed=400.00000
LaserEngraveBlowGasType=1
LaserEngraveFillCircleR=2.50000
LaserEngraveFillCircleSpace=2.50000
LaserEngraveFillCircle=0
LaserEngraveFillCircleType=0
LaserEngraveTwoDirector=0
LaserEngraveScanDirector=1
LaserEngraveScanStepLen=0.06400
LaserEngraveExpandPenWidth=0
LaserEngraveExpandPenWidthScale=15.00000
GROUP_ROWS_0=1
GROUP_COLUMNS_0=1
GROUP_ROWSPACE_0=0.00000
GROUP_COLUMNSPACE_0=0.00000
GROUP_ROWCWSPACE_0=0.00000
GROUP_COLUMNCWSPACE_0=0.00000
GROUP_MINX_0=588.75275
GROUP_MAXX_0=648.05881
GROUP_MINY_0=299.94030
GROUP_MAXY_0=336.61513
