StuartKenny/PRS10_rack/(commit log)

2018-02-23 Add files via upload
    Layout on the PRS motherboard underway - Bulk AC to DC complete
    [BoM.xlsx, Enclosure.0001.ipt, Enclosure.ipt, LED_daughterboard.pdsprj, LM338_divider.xlsx, LM723_divider.xlsx, PRS10.pdsprj, PRS10_connectorboard.pdsprj]
2018-02-28 v0.5 Gerbers sent for manufacture
    Motherboard layout complete
    [BoM.xlsx, Component_defn.pdsprj, LED_daughterboard.pdsprj, PRS10.pdsprj, PRS10_connectorboard.pdsprj]
2018-03-02 v0.6 gerbers for mobo
    Removed all instances of 0.85mm holes. Fixed 22uF footprint
    [Component_defn.pdsprj, PRS10.pdsprj]
2018-04-02 Added PRSBB & corrections
    Added PRS10 breakout board and numerous corrections to footprints
    [BoM.xlsx, Component_defn.pdsprj, PRS10.pdsprj, PRS10_connectorboard.pdsprj, PRSBB2.pdsprj]
2018-05-22 v1.0
    All boards manufactured, populated and undergoing bring-up
    [BoM.xlsx, Component_defn.pdsprj, PRS10.pdsprj, PRS10_connectorboard.pdsprj, PRSBB2.pdsprj]
2018-05-31 Front panel outline & cutouts
    [BoM.xlsx, Panel.0003.dwg, Panel.0011.ipt, Panel.dwg, Panel.ipt]
2018-06-04 Added front panel DXF
    [Panel.0011.ipt, Panel.0013.ipt, Panel.ipt, Panelv03.dxf, try1.dwg]
2018-07-04 Built - inc. front panel
    [BoM.xlsx, PRS10_BoM.xlsx, Panel.0003.dwg, Panel.0004.dwg, Panel.0013.ipt, Panel.0014.ipt, Panel.dwg, Panel.ipt]
